KendaroDuong/imu-final-board/docs/Hardware Design - Rev-02 draft.docx

# Hardware Design

# Rev-01

### Description

Rev-01 is the first board revision meant as a working prototype. A defining characteristic of the first revision is the footprint being 60mm x60mm where as our stretch goal is to have the board in the m.2 2260 format.

### Goal

The goal of rev-01 is to simply break out the chosen sensors and connect their pinouts to the STM32-4f11 development board and support the early proof of concept testing.

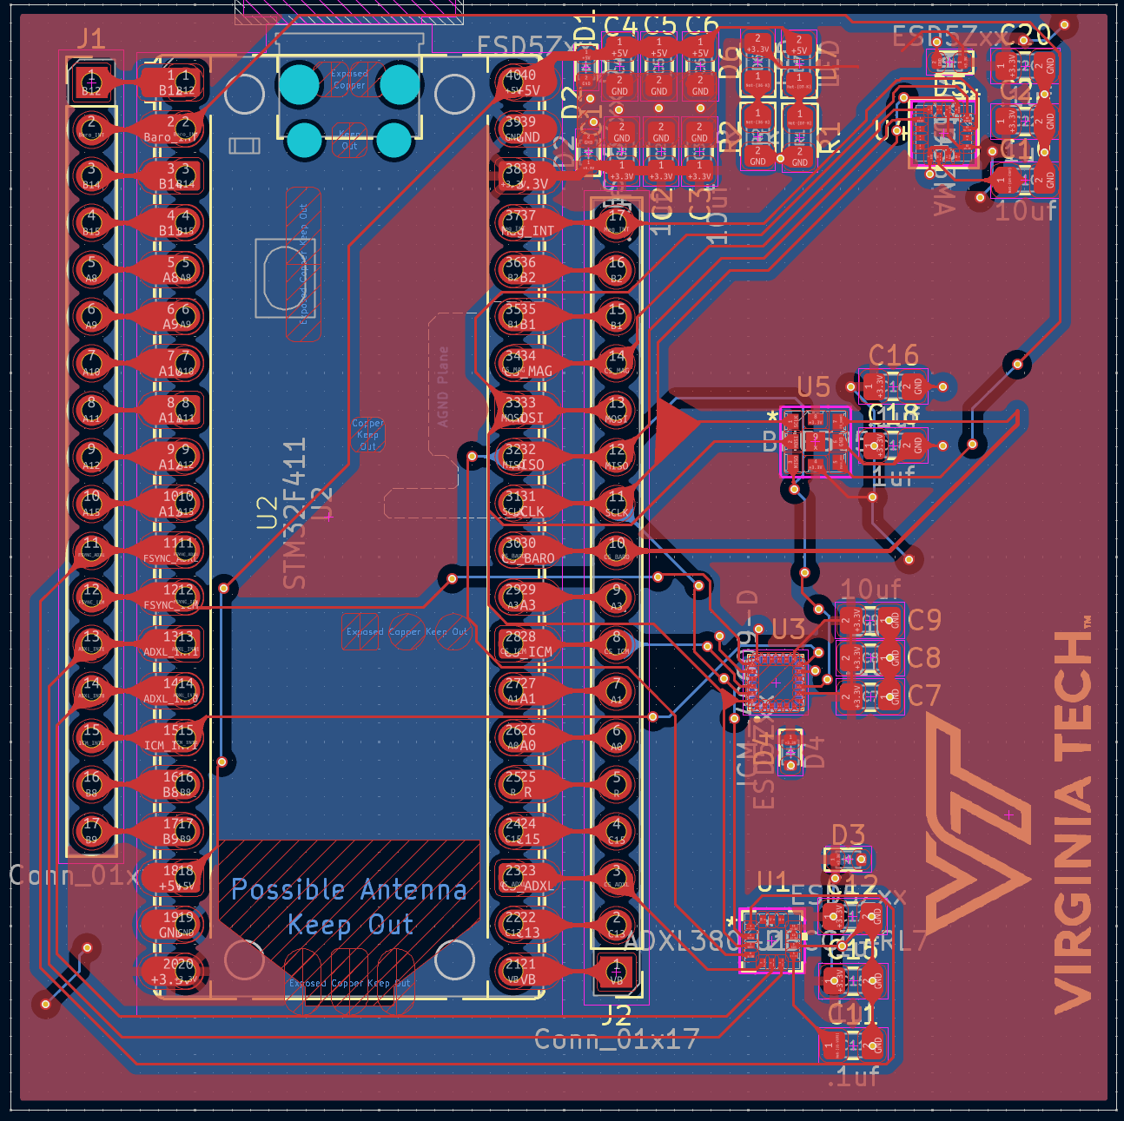
[picture p1: figure]
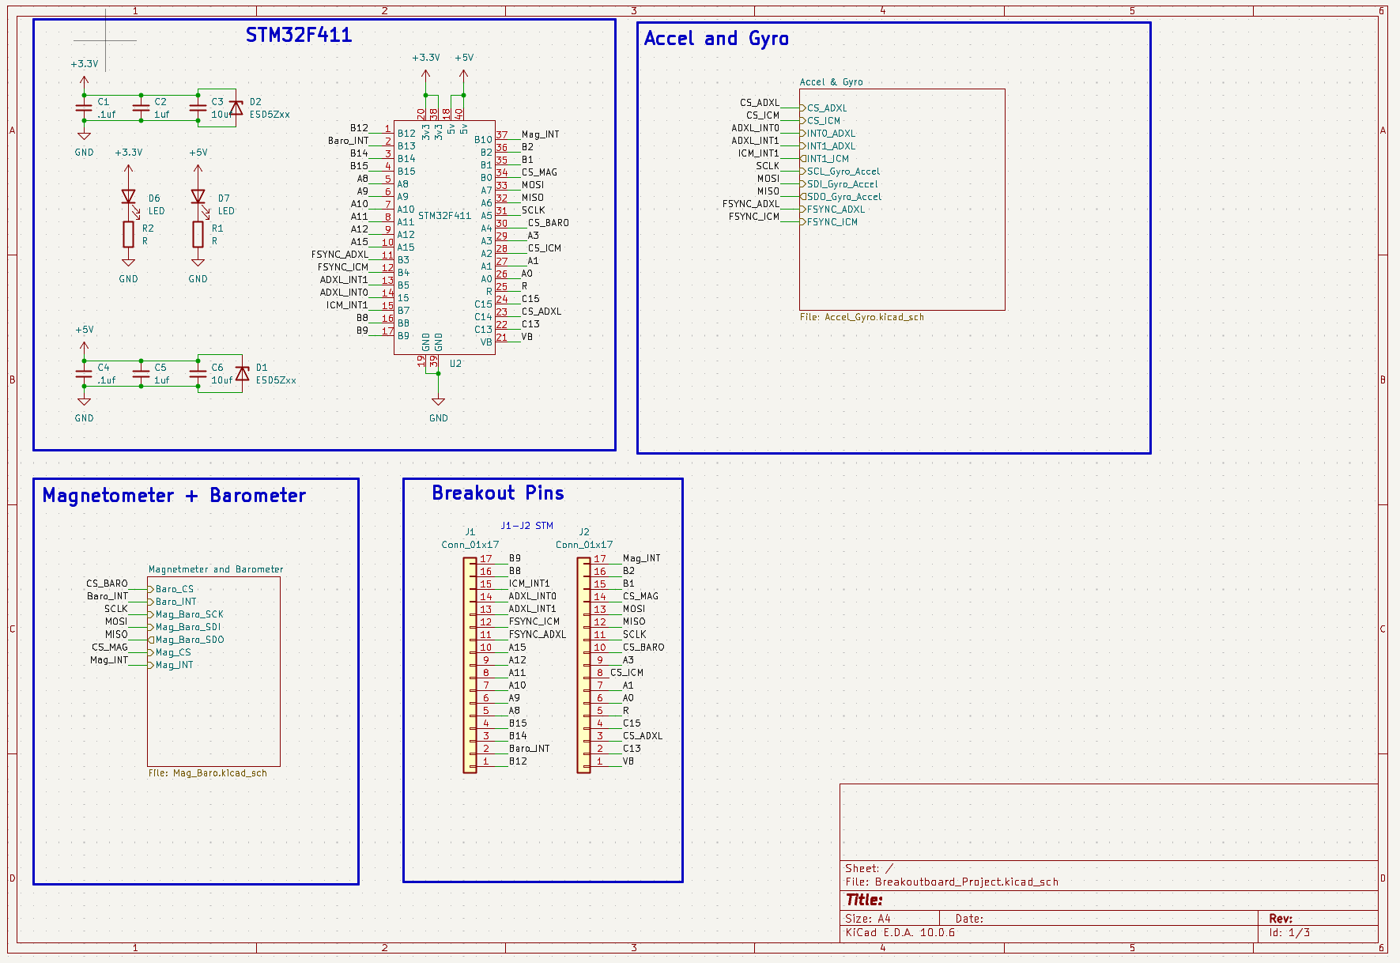
[picture p2: figure]

Requirements Supported

Need | How Rev-01 supports it | Test
N1 Linear acceleration | ADXL380, plus the second accelerometer in the ICM-40609-D | T1, T2
N2 Angular rate | ICM-40609-D gyroscope | T3, T4
N3 Absolute heading | MMC5983MA magnetometer | T5
N4 Altitude aiding | BMP585 barometer (300–1250 mbar, the marginal target) | T6
N5 Fast, deterministic data | Shared SPI1 bus, one chip select per sensor, interrupts and FSYNC lines routed to the MCU | T7, T8
N6 Integration (partial) | UART and USB-C through the Black Pill; 60 mm x 60 mm meets the marginal form factor of 100 mm x 100 mm or less | T9
N8 Real-time demo | Streams sensor data to the host PC for visualization | T13

# Rev-02

### Description

Rev-02 is the final board. It moves the design from a breakout board that carries a development board to a self-contained IMU card. The STM32F411 is soldered directly to the board, and the target footprint is the M.2 2260 format (22 mm x 60 mm). The sensors, shared SPI bus and sensor circuits stay the same as Rev-01, so the firmware and test results carry over. M.2 remains a stretch goal from Psionic. If it cannot be finished in time, the same circuit will be built on the Rev-01 60 mm x 60 mm outline.

### Goal

The goal of Rev-02 is to deliver a single board that Psionic can integrate with its navigation products. It should power itself from the host, stream measurements over UART and USB, and accept an external measurement trigger, with protection on every external connection.

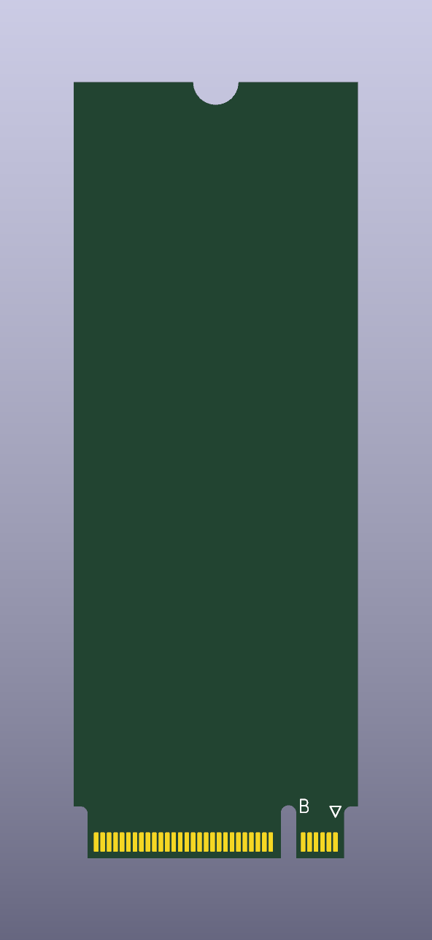
[picture p3: figure]
Rev-02 M.2 2260 Key B board outline rendered from KiCad

Figure: Rev-02 M.2 2260 Key B outline in KiCad. Placement and routing have not started.

### Changes from Rev-01

Area | Rev-01 breakout board | Rev-02 final board | Why
Form factor | 60 mm x 60 mm, 2-layer, 1.6 mm thick | M.2 2260 (22 mm x 60 mm), Key B, 4-layer, 0.8 mm thick | Psionic's M.2 integration goal. The narrow board needs inner ground and power layers.
Microcontroller | Black Pill development board plugged into headers | STM32F411CEU6 soldered directly to the board, with crystal, VCAP capacitor, BOOT0 pull-down and reset circuit | The Black Pill does not fit on an M.2 card. Using the same MCU keeps the firmware portable.
Power | USB 5 V to the Black Pill's 3.3 V regulator; +5 V and +3.3 V rails | 3.3 V from the M.2 connector, filtered for the sensors; no +5 V rail or USB-C connector | M.2 hosts supply 3.3 V directly.
Host link | UART and USB through the Black Pill | USB 2.0 and UART through M.2 connector pins | Keeps the UART baseline and the USB stretch goal without a separate connector.
External trigger | None; FSYNC is driven only by MCU pins | New protected TRIG_IN with series resistor and clamp, on a timer capture pin (PA0, TIM5_CH1) | The V&V plan uses an external trigger of about 50 µs every 10 ms, which must stay within the 3.3 V GPIO limits.
ESD protection | TVS diodes on the power rails only | Protection on every external line: USB, UART, TRIG_IN and power | Required by V&V tests TC04 and TC06.
ADXL380 chip select | PC14 | PA3 | PC13–PC15 are limited to 2 MHz, 30 pF and a 3 mA sink (STM32F411 datasheet).
Test access | J1 and J2, 2.54 mm headers | Test pads for SPI, CS, INT, FSYNC, TRIG_IN, UART, SWD and power | Through-hole headers do not fit on the card.
Bench connection | Black Pill USB-C connects directly to the PC | Small M.2 carrier board with socket, USB-C, UART and trigger connectors, and 2.54 mm headers | The card cannot connect to a laptop by itself, and the V&V plan expects 2.54 mm probe access.
Passives and LEDs | 0805 hand-solder parts; power LEDs on both rails | Smaller passives where needed; one 3.3 V power LED and one MCU status LED | Saves board area, and the +5 V rail is gone.
Sensor placement | Sensors spread around the Black Pill | Accelerometer and gyroscope close together away from board edges; magnetometer away from the steel mounting screw and high-current traces | Reduces board-flex and magnetic error on the longer, thinner card.

### What Stays the Same

Rev-02 keeps the ADXL380, ICM-40609-D, MMC5983MA and BMP585, the shared SPI1 bus (PA5, PA6, PA7), one chip select per sensor, the interrupt and FSYNC pin assignments, and the decoupling on each sensor. The only sensor pin that moves is the ADXL380 chip select.

## Requirements Supported

Need | How Rev-02 supports it | Test
N1–N4 Sensing | Same four sensors and sensor circuits as Rev-01 | T1–T6
N5 Fast, deterministic data | Direct MCU connection to the sensors; timer capture of the external trigger | T7, T8
N6 Integration with Psionic | UART and USB over M.2, protected external sync input, M.2 2260 form factor (ideal target) | T9, T10
N7 Field environment | 3.3 V supply within the 3.2–5.2 V target; no 5 V regulator losses, with power still to be measured against the 280 mW target | T11, T12
N8 Real-time demo | Connects to the host PC through the carrier board | T13

### Open Decisions

Open decision | Owner | Proposed answer
Which M.2 key does Psionic's host use? | Team / Psionic | Key B, because it includes USB 2.0 and fits the 2260 size
Which M.2 pins carry UART and TRIG_IN? | Team / Psionic | To be chosen after checking the M.2 specification, since these signals are not standard M.2 functions
Is the carrier board in scope? | Team / mentor | Yes, as a simple 2-layer board for the demo and V&V
Can the team assemble 0.8 mm, fine-pitch boards? | Team / lab staff | Use a stencil, or fab assembly if hand assembly is not reliable
What is the fallback if M.2 slips? | Team / mentor | Same circuit on the 60 mm x 60 mm outline, with USB-C and a 3.3 V regulator
