KendaroDuong/imu-final-board/docs/Final_Board_schematic.pdf

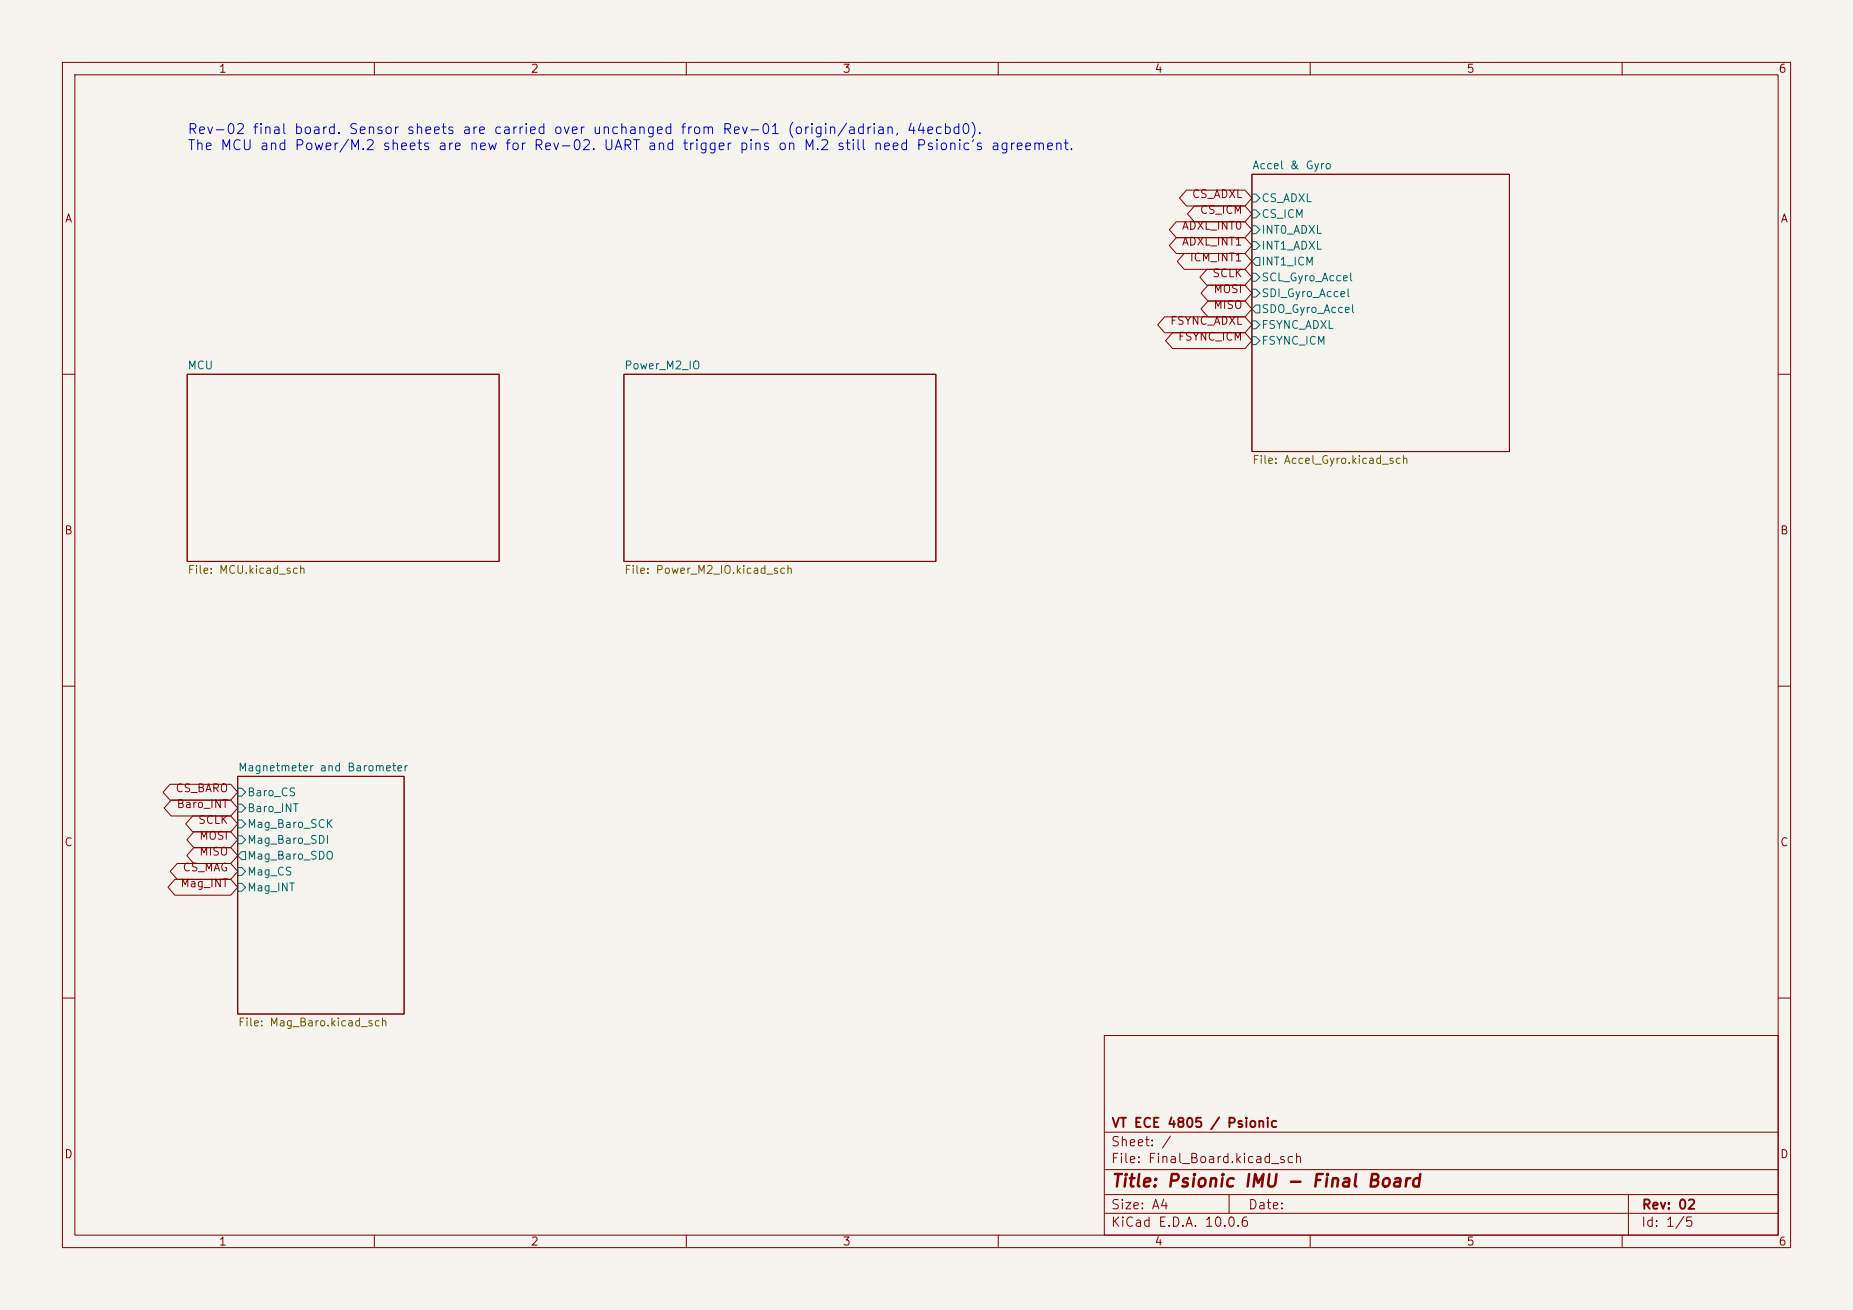
[picture p4: page 1]

Rev-02 final board. Sensor sheets are carried over unchanged from Rev-01 (origin/adrian, 44ecbd0).
The MCU and Power/M.2 sheets are new for Rev-02. UART and trigger pins on M.2 still need Psionic's agreement.

Magnetmeter and Barometer File: Mag_Baro.kicad_sch

VT ECE 4805 / Psionic
Sheet: /
File: Final_Board.kicad_sch
Title: Psionic IMU - Final Board

Size: A4 | Rev: 02
KiCad E.D.A. 10.0.6 | Id: 1/5

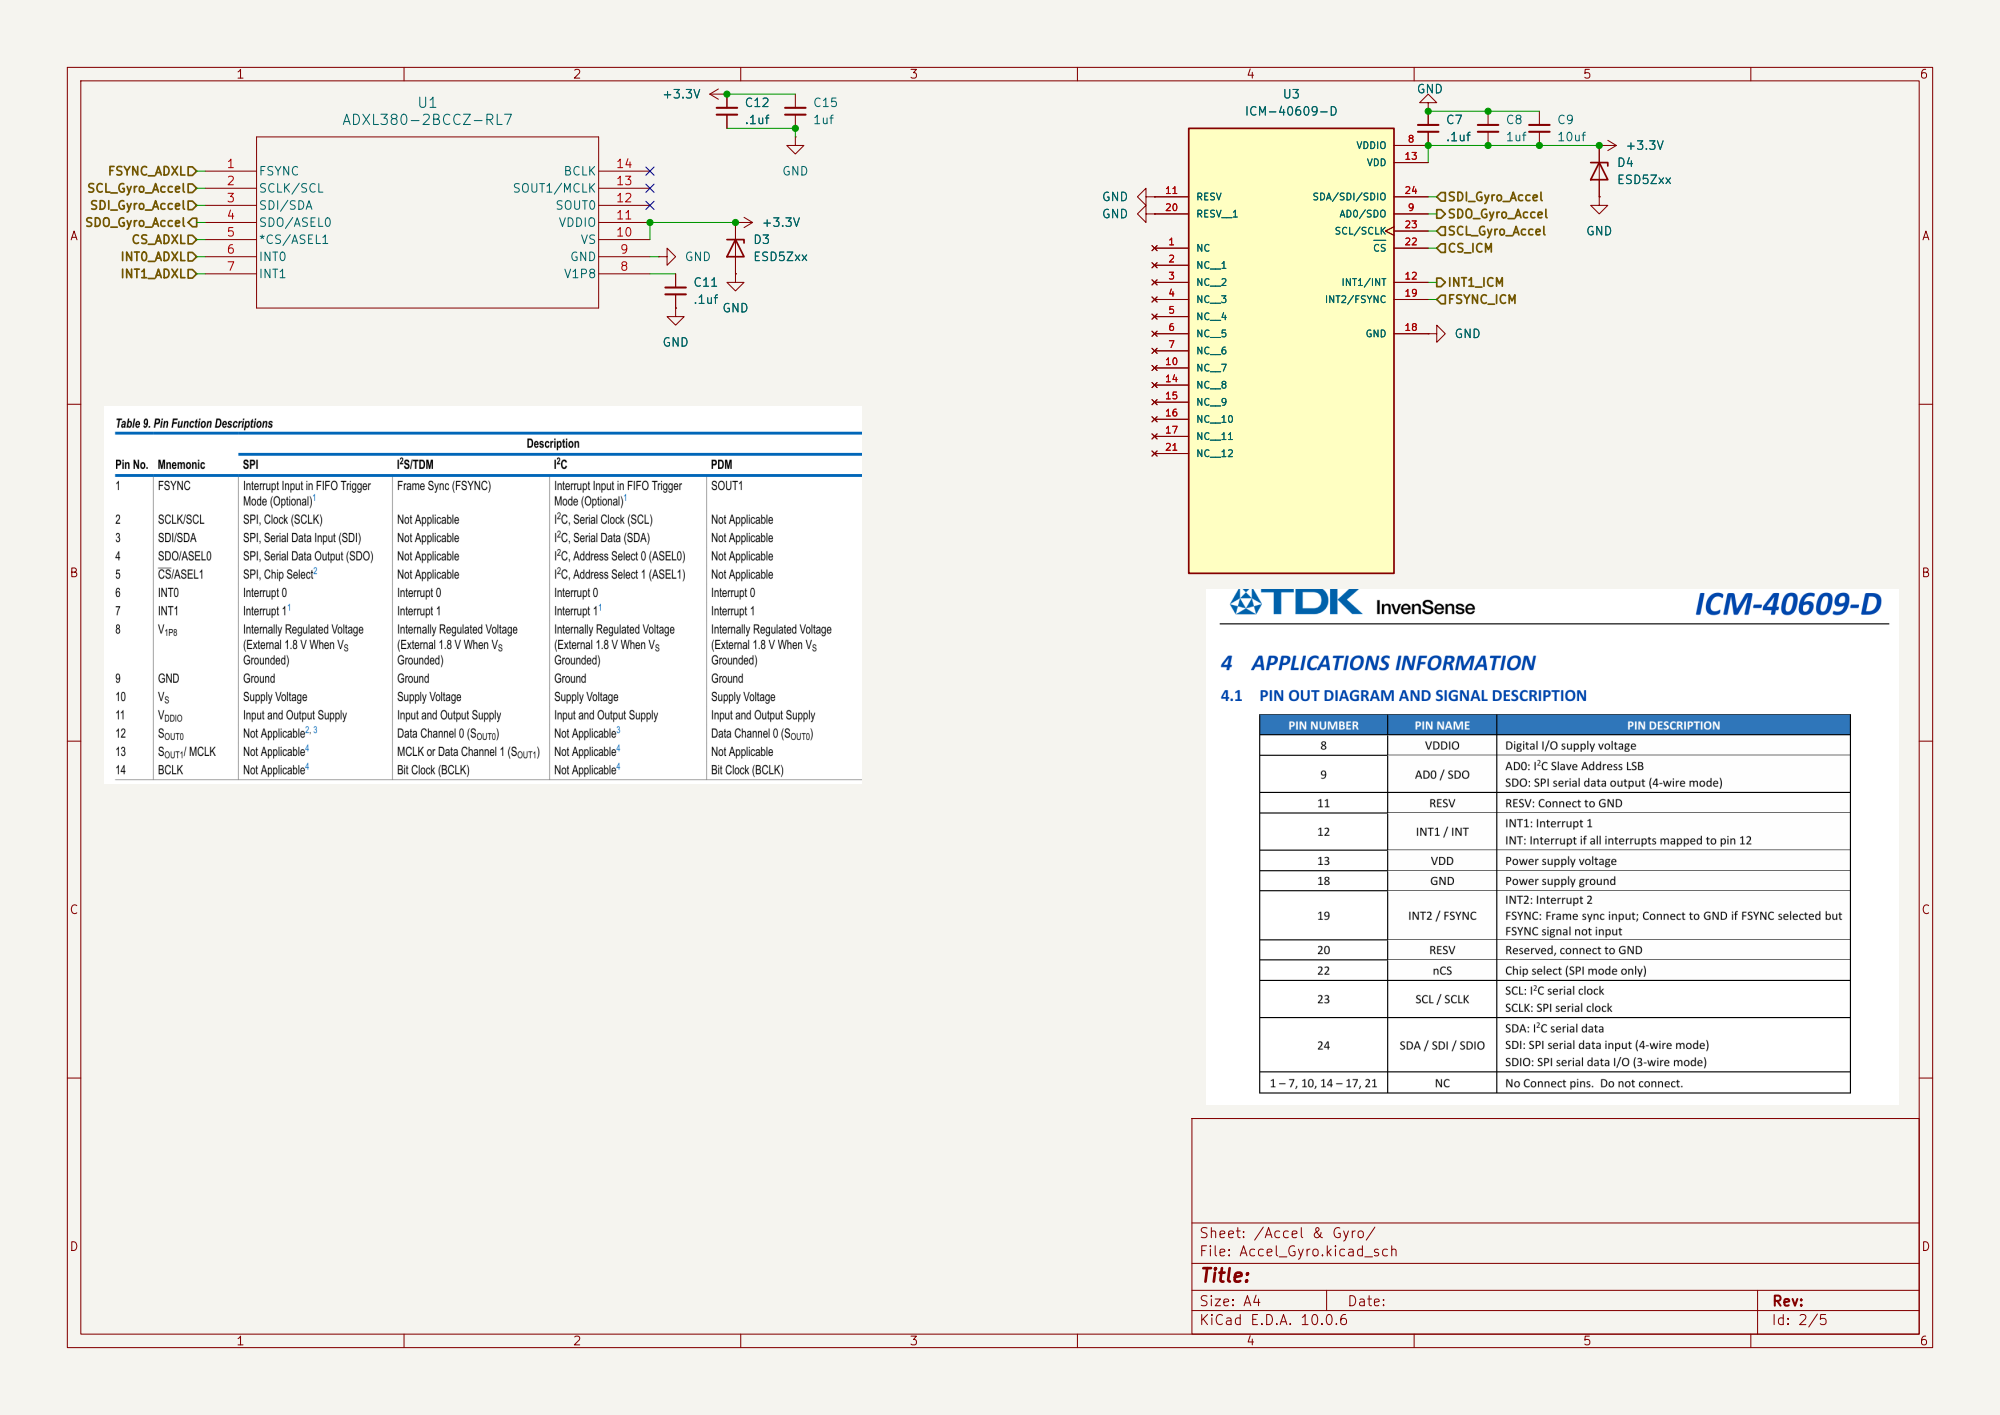
[picture p5: page 2]

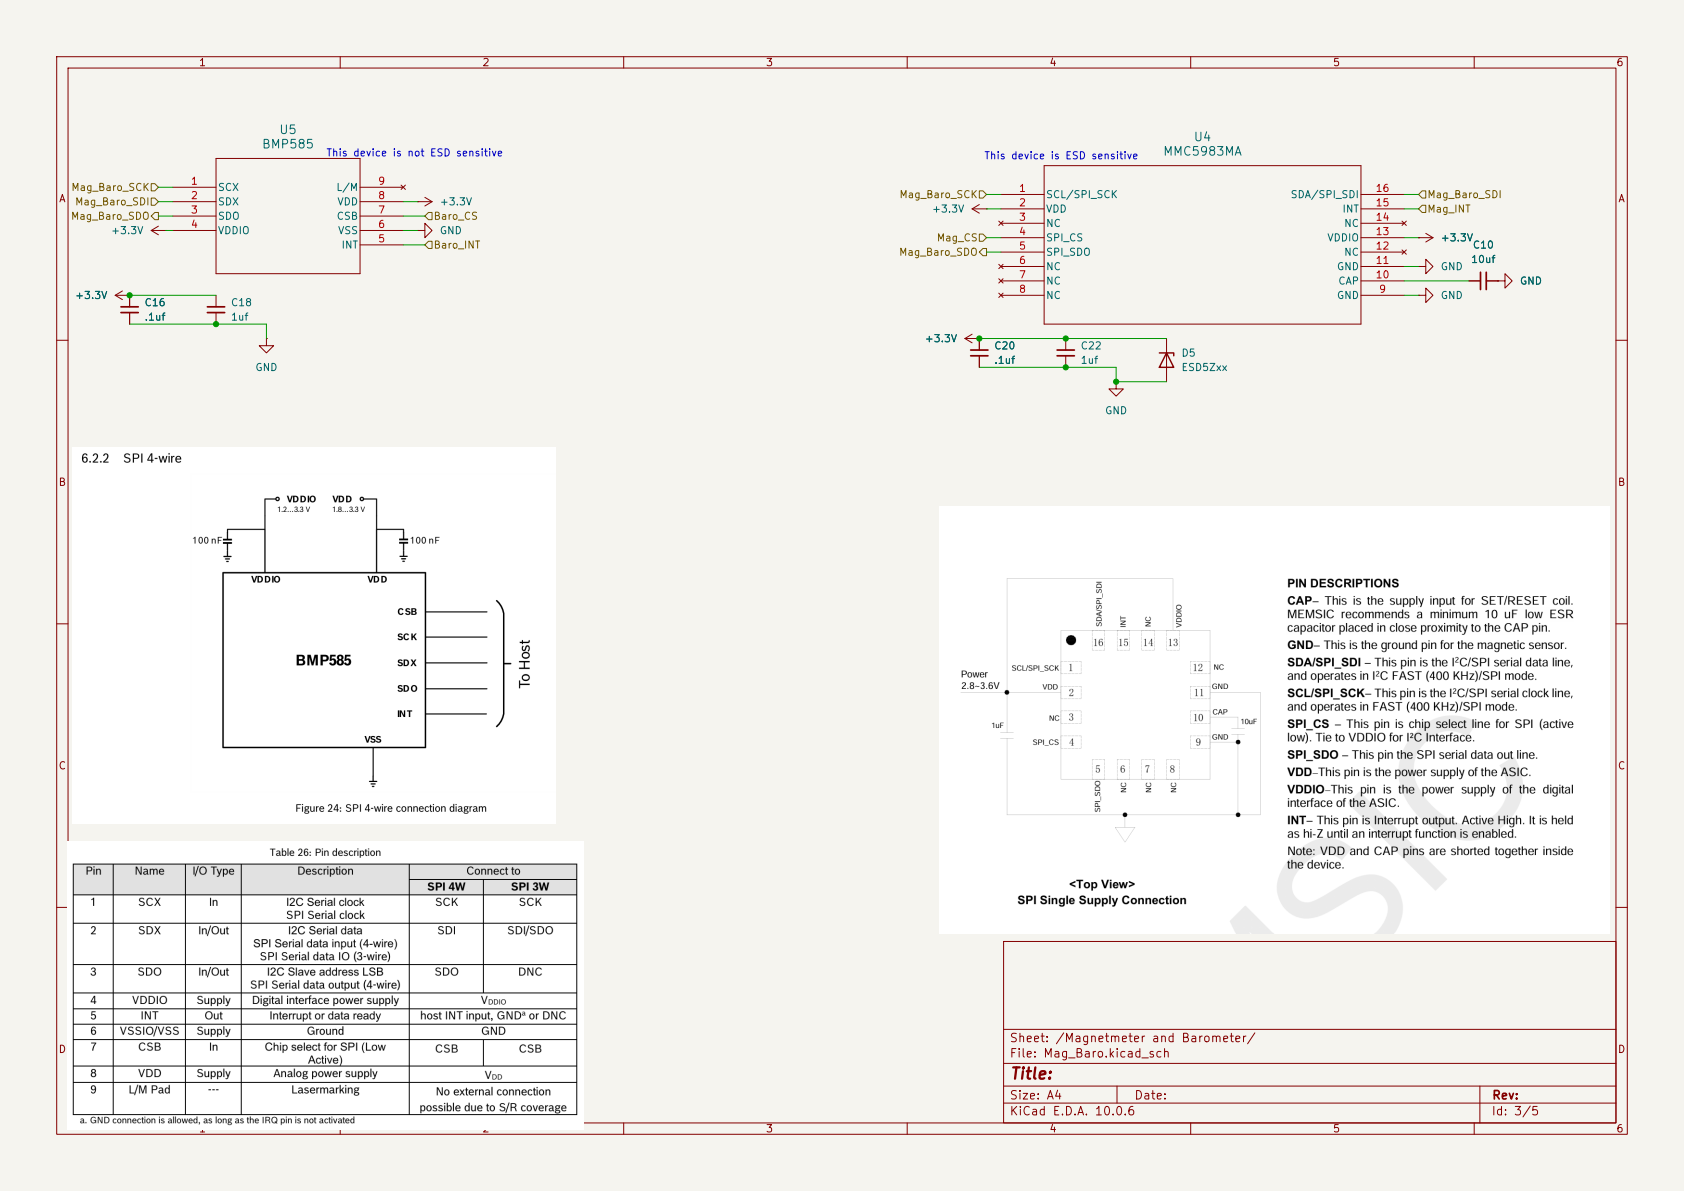
[picture p6: page 3]

Sheet: /Magnetmeter and Barometer/
File: Mag_Baro.kicad_sch
Title:

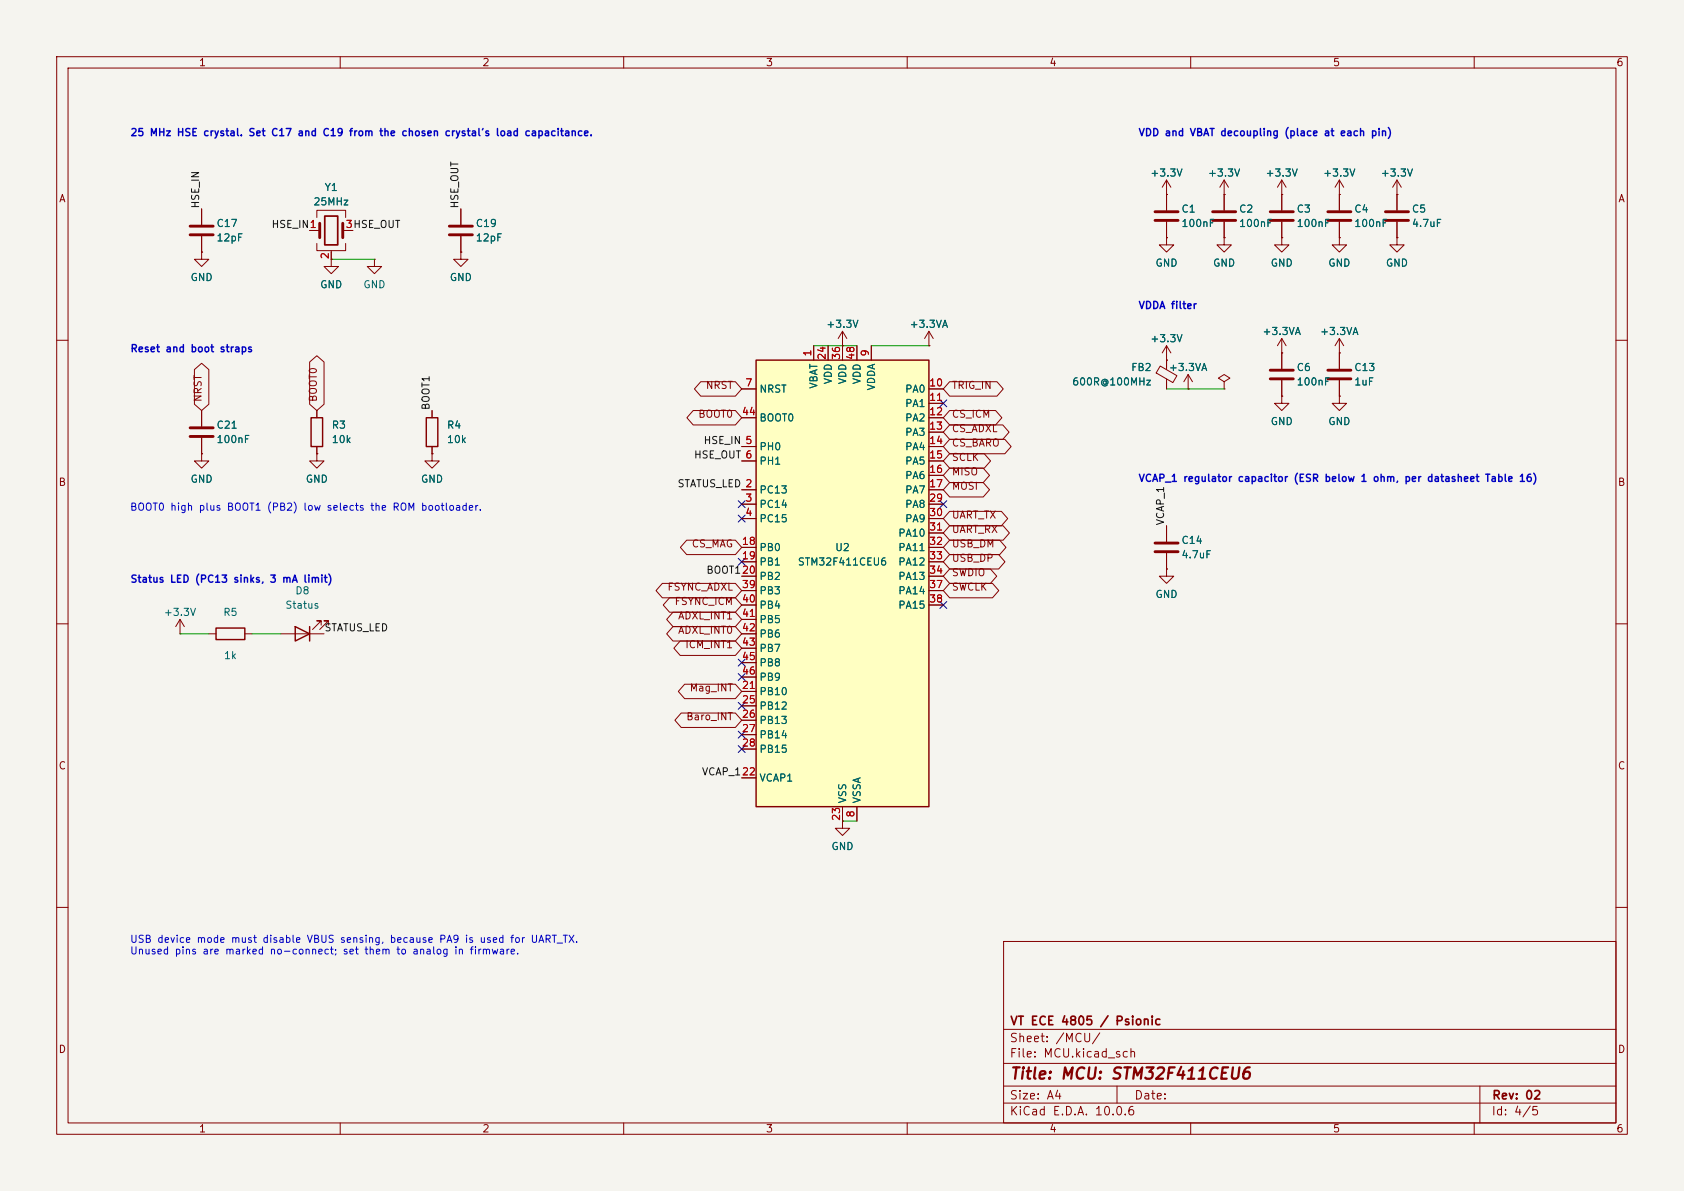
[picture p7: page 4]

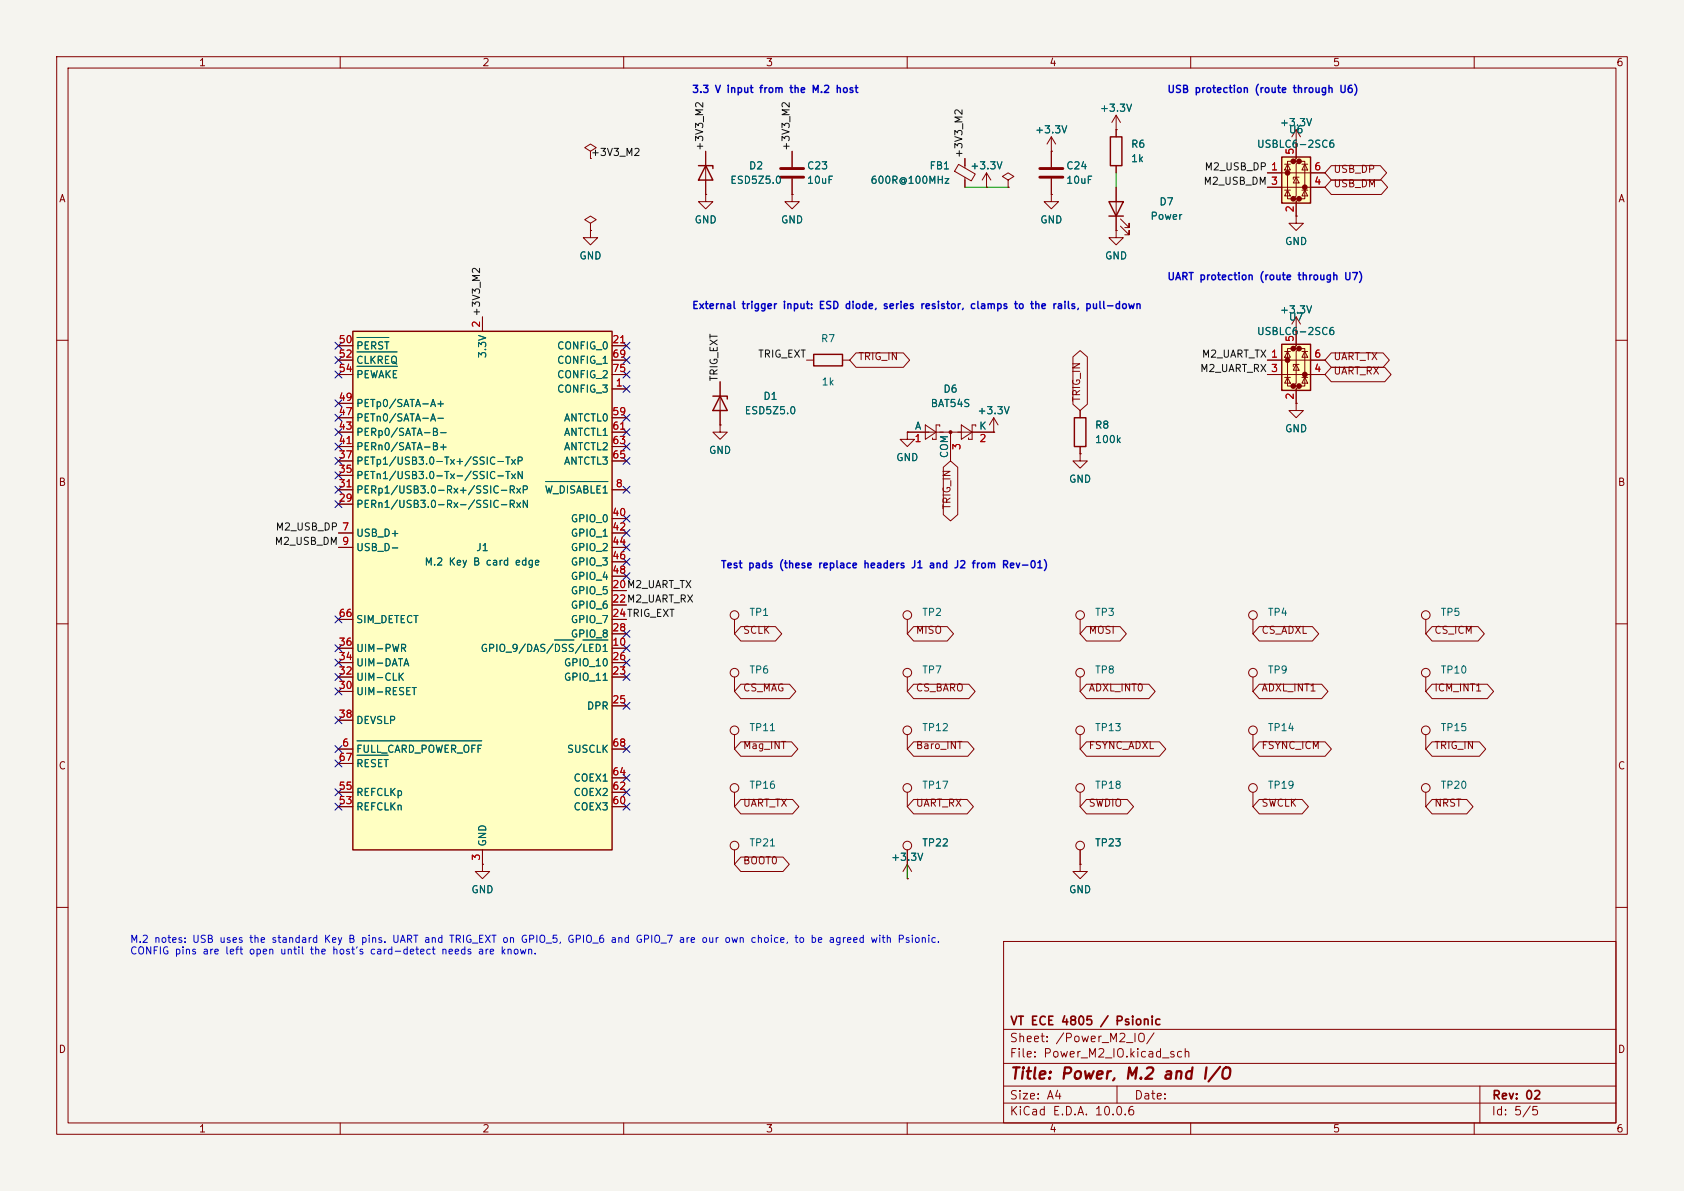
[picture p8: page 5]
