KendaroDuong/imu-final-board/Final_Board/Accel_Gyro.kicad_sch

## KiCad design Final_Board/Accel_Gyro.kicad_sch (2026-11-06)

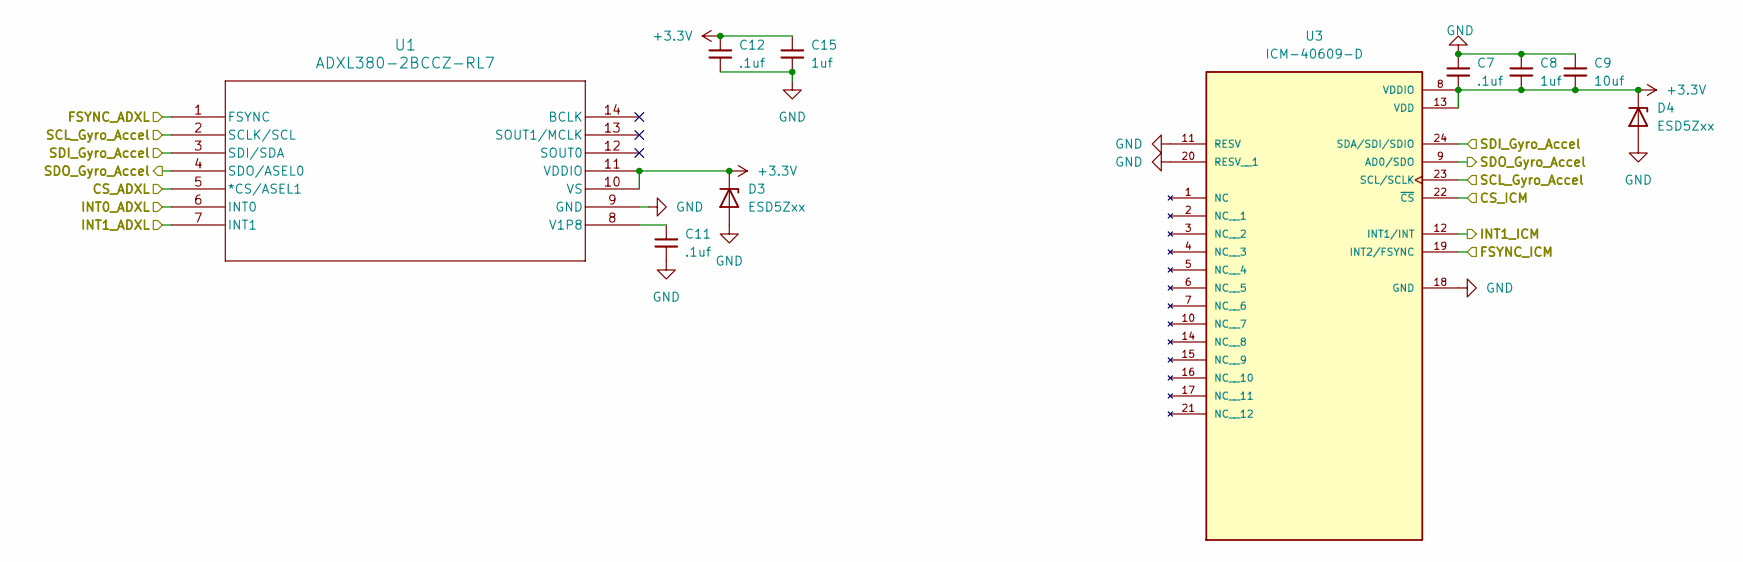
[picture p9: schematic Accel_Gyro.kicad_sch]

Parts:
C7, C11, C12: .1uf; C_0805_2012Metric_Pad1.18x1.45mm_HandSolder
C8, C15: 1uf; C_0805_2012Metric_Pad1.18x1.45mm_HandSolder
C9: 10uf; C_0805_2012Metric_Pad1.18x1.45mm_HandSolder
D3, D4: ESD5Zxx; D_SOD-523
U1: ADXL380-2BCCZ-RL7; CC-14-3_ADI
U3: ICM-40609-D; XDCR_ICM-40609-D; PARTREV 1.2

Connections:
+3.3V: C7.2, C8.2, C9.2, C12.1, C15.1, D3.1 (K), D4.1 (K), U1.10 (VS), U1.11 (VDDIO), U3.8 (VDDIO), U3.13 (VDD)
CS_ADXL: U1.5 (*CS/ASEL1)
CS_ICM: U3.22 (~CS)
FSYNC_ADXL: U1.1 (FSYNC)
FSYNC_ICM: U3.19 (INT2/FSYNC)
GND: C7.1, C8.1, C9.1, C11.2, C12.2, C15.2, D3.2 (A), D4.2 (A), U1.9 (GND), U3.11 (RESV), U3.18 (GND), U3.20 (RESV__1)
INT0_ADXL: U1.6 (INT0)
INT1_ADXL: U1.7 (INT1)
INT1_ICM: U3.12 (INT1/INT)
unnamed: C11.1, U1.8 (V1P8)
SCL_Gyro_Accel: U1.2 (SCLK/SCL), U3.23 (SCL/SCLK)
SDI_Gyro_Accel: U1.3 (SDI/SDA), U3.24 (SDA/SDI/SDIO)
SDO_Gyro_Accel: U1.4 (SDO/ASEL0), U3.9 (AD0/SDO)
