KendaroDuong/imu-final-board/Final_Board/MCU.kicad_sch

## KiCad design Final_Board/MCU.kicad_sch (2026-11-06)

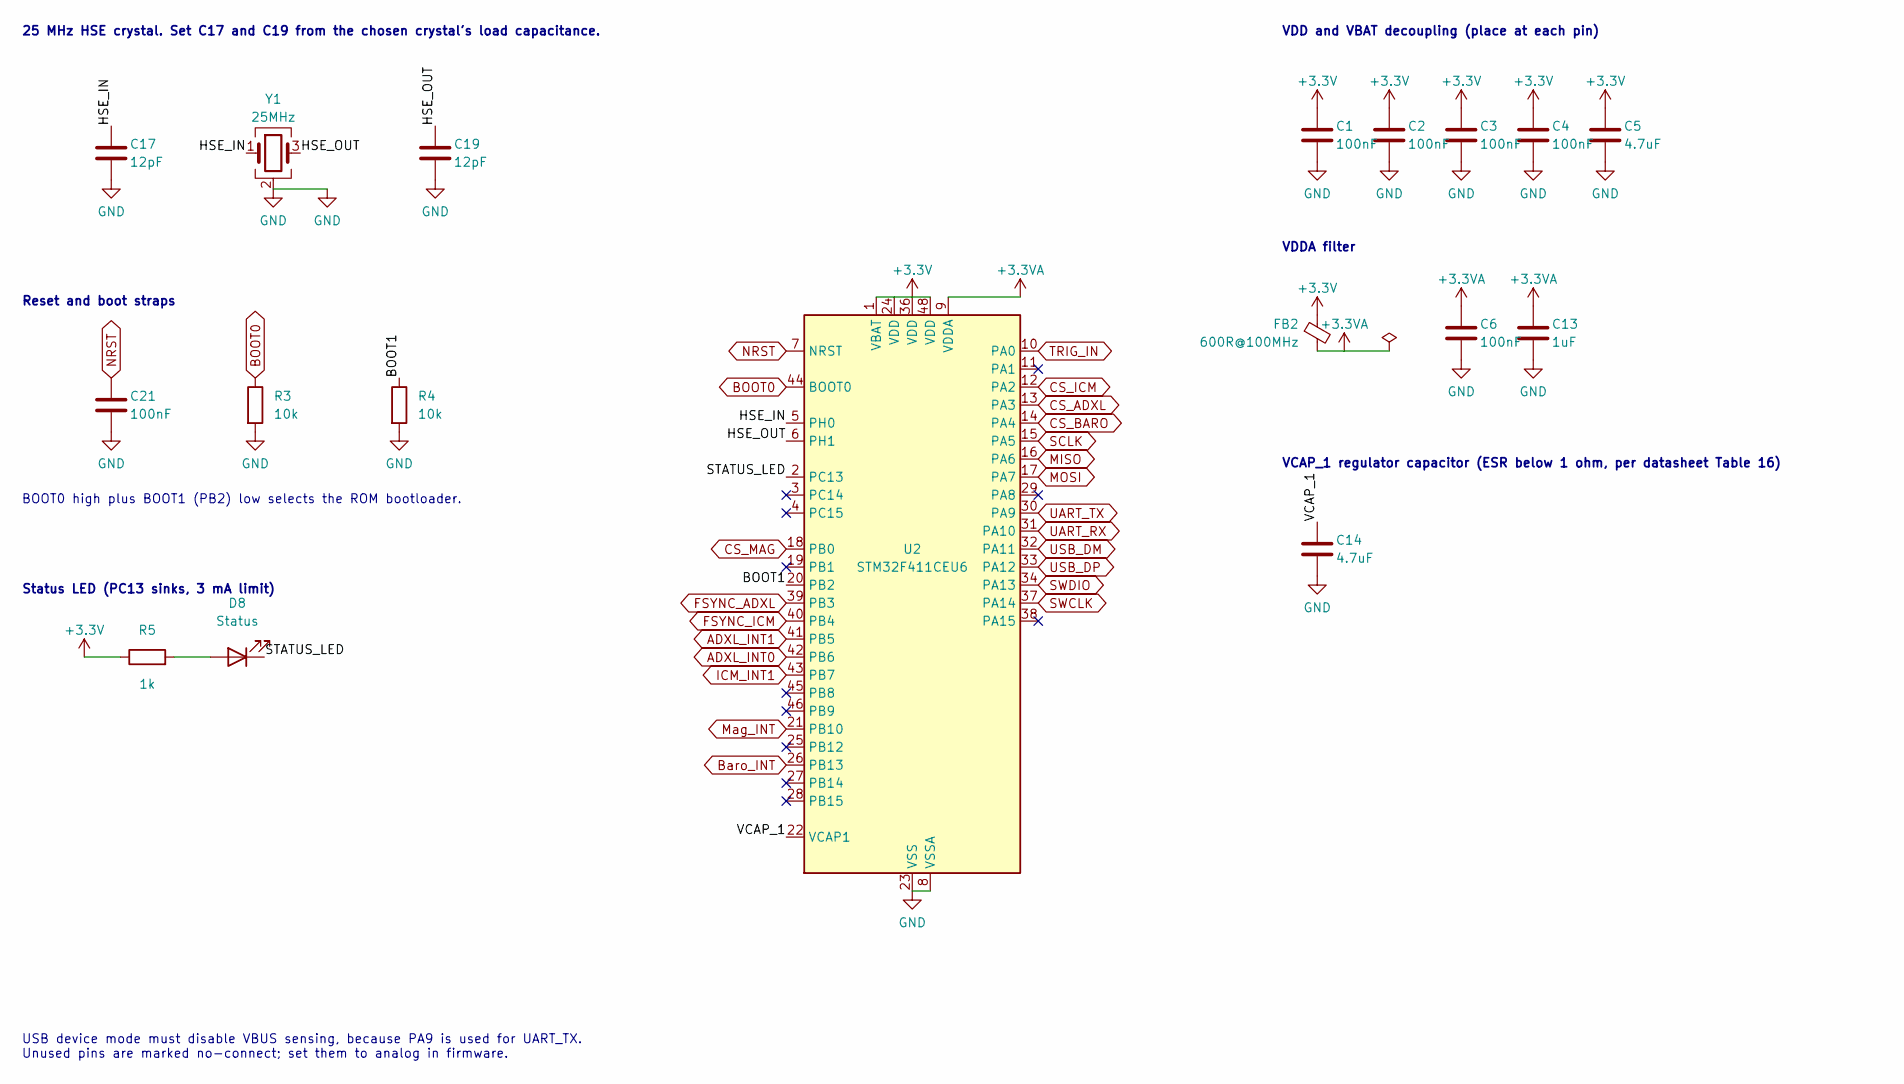
[picture p10: schematic MCU.kicad_sch]

Parts:
C1, C2, C3, C4, C6, C21: 100nF; C_0402_1005Metric
C5, C14: 4.7uF; C_0603_1608Metric
C13: 1uF; C_0402_1005Metric
C17, C19: 12pF; C_0402_1005Metric
D8: Status; LED_0603_1608Metric
FB2: 600R@100MHz; L_0402_1005Metric
R3, R4: 10k; R_0402_1005Metric
R5: 1k; R_0402_1005Metric
U2: STM32F411CEU6; QFN-48-1EP_7x7mm_P0.5mm_EP5.6x5.6mm
Y1: 25MHz; Crystal_SMD_3225-4Pin_3.2x2.5mm

Connections:
+3.3V: C1.1, C2.1, C3.1, C4.1, C5.1, FB2.1, R5.1, U2.1 (VBAT), U2.24 (VDD), U2.36 (VDD), U2.48 (VDD)
+3.3VA: C6.1, C13.1, FB2.2, U2.9 (VDDA)
ADXL_INT0: U2.42 (PB6)
ADXL_INT1: U2.41 (PB5)
BOOT0: R3.1, U2.44 (BOOT0)
BOOT1: R4.1, U2.20 (PB2)
Baro_INT: U2.26 (PB13)
CS_ADXL: U2.13 (PA3)
CS_BARO: U2.14 (PA4)
CS_ICM: U2.12 (PA2)
CS_MAG: U2.18 (PB0)
FSYNC_ADXL: U2.39 (PB3)
FSYNC_ICM: U2.40 (PB4)
GND: C1.2, C2.2, C3.2, C4.2, C5.2, C6.2, C13.2, C14.2, C17.2, C19.2, C21.2, R3.2, R4.2, U2.8 (VSSA), U2.23 (VSS), U2.35 (VSS), U2.47 (VSS), U2.49 (VSS), Y1.2 (G), Y1.4 (G)
HSE_IN: C17.1, U2.5 (PH0), Y1.1
HSE_OUT: C19.1, U2.6 (PH1), Y1.3
ICM_INT1: U2.43 (PB7)
MISO: U2.16 (PA6)
MOSI: U2.17 (PA7)
Mag_INT: U2.21 (PB10)
NRST: C21.1, U2.7 (NRST)
unnamed: D8.2 (A), R5.2
SCLK: U2.15 (PA5)
STATUS_LED: D8.1 (K), U2.2 (PC13)
SWCLK: U2.37 (PA14)
SWDIO: U2.34 (PA13)
TRIG_IN: U2.10 (PA0)
UART_RX: U2.31 (PA10)
UART_TX: U2.30 (PA9)
USB_DM: U2.32 (PA11)
USB_DP: U2.33 (PA12)
VCAP_1: C14.1, U2.22 (VCAP1)

Notes on the sheet:
VDD and VBAT decoupling (place at each pin)
Status LED (PC13 sinks, 3 mA limit)
BOOT0 high plus BOOT1 (PB2) low selects the ROM bootloader.
VDDA filter
Reset and boot straps
VCAP_1 regulator capacitor (ESR below 1 ohm, per datasheet Table 16)
25 MHz HSE crystal. Set C17 and C19 from the chosen crystal's load capacitance.
USB device mode must disable VBUS sensing, because PA9 is used for UART_TX. Unused pins are marked no-connect; set them to analog in firmware.
