KendaroDuong/imu-final-board/Final_Board/Mag_Baro.kicad_sch

## KiCad design Final_Board/Mag_Baro.kicad_sch (2026-11-06)

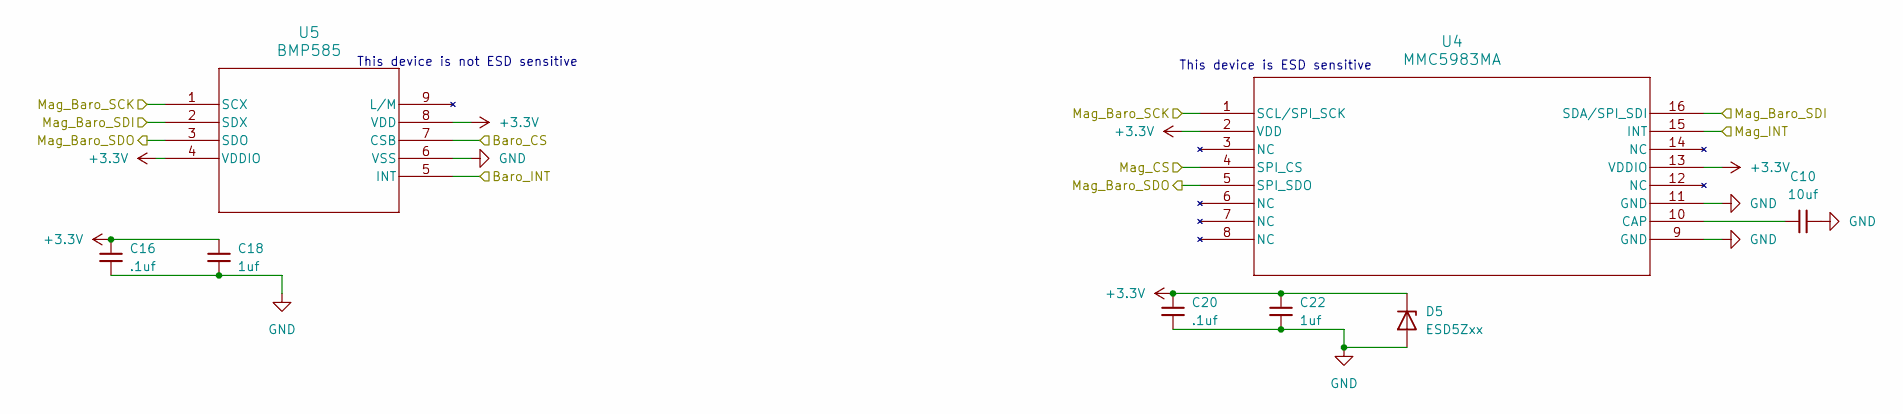
[picture p11: schematic Mag_Baro.kicad_sch]

Parts:
C10: 10uf; C_0805_2012Metric_Pad1.18x1.45mm_HandSolder
C16, C20: .1uf; C_0805_2012Metric_Pad1.18x1.45mm_HandSolder
C18, C22: 1uf; C_0805_2012Metric_Pad1.18x1.45mm_HandSolder
D5: ESD5Zxx; D_SOD-523
U4: MMC5983MA; MMC5983MA_MEM
U5: BMP585; LGA9_BMP585_BOS

Connections:
+3.3V: C16.1, C18.1, C20.1, C22.1, D5.1 (K), U4.2 (VDD), U4.13 (VDDIO), U5.4 (VDDIO), U5.8 (VDD)
Baro_CS: U5.7 (CSB)
Baro_INT: U5.5 (INT)
GND: C10.2, C16.2, C18.2, C20.2, C22.2, D5.2 (A), U4.9 (GND), U4.11 (GND), U5.6 (VSS)
Mag_Baro_SCK: U4.1 (SCL/SPI_SCK), U5.1 (SCX)
Mag_Baro_SDI: U4.16 (SDA/SPI_SDI), U5.2 (SDX)
Mag_Baro_SDO: U4.5 (SPI_SDO), U5.3 (SDO)
Mag_CS: U4.4 (SPI_CS)
Mag_INT: U4.15 (INT)
unnamed: C10.1, U4.10 (CAP)

Notes on the sheet:
This device is not ESD sensitive
This device is ESD sensitive
