KendaroDuong/imu-final-board/Final_Board/Power_M2_IO.kicad_sch

## KiCad design Final_Board/Power_M2_IO.kicad_sch (2026-11-06)

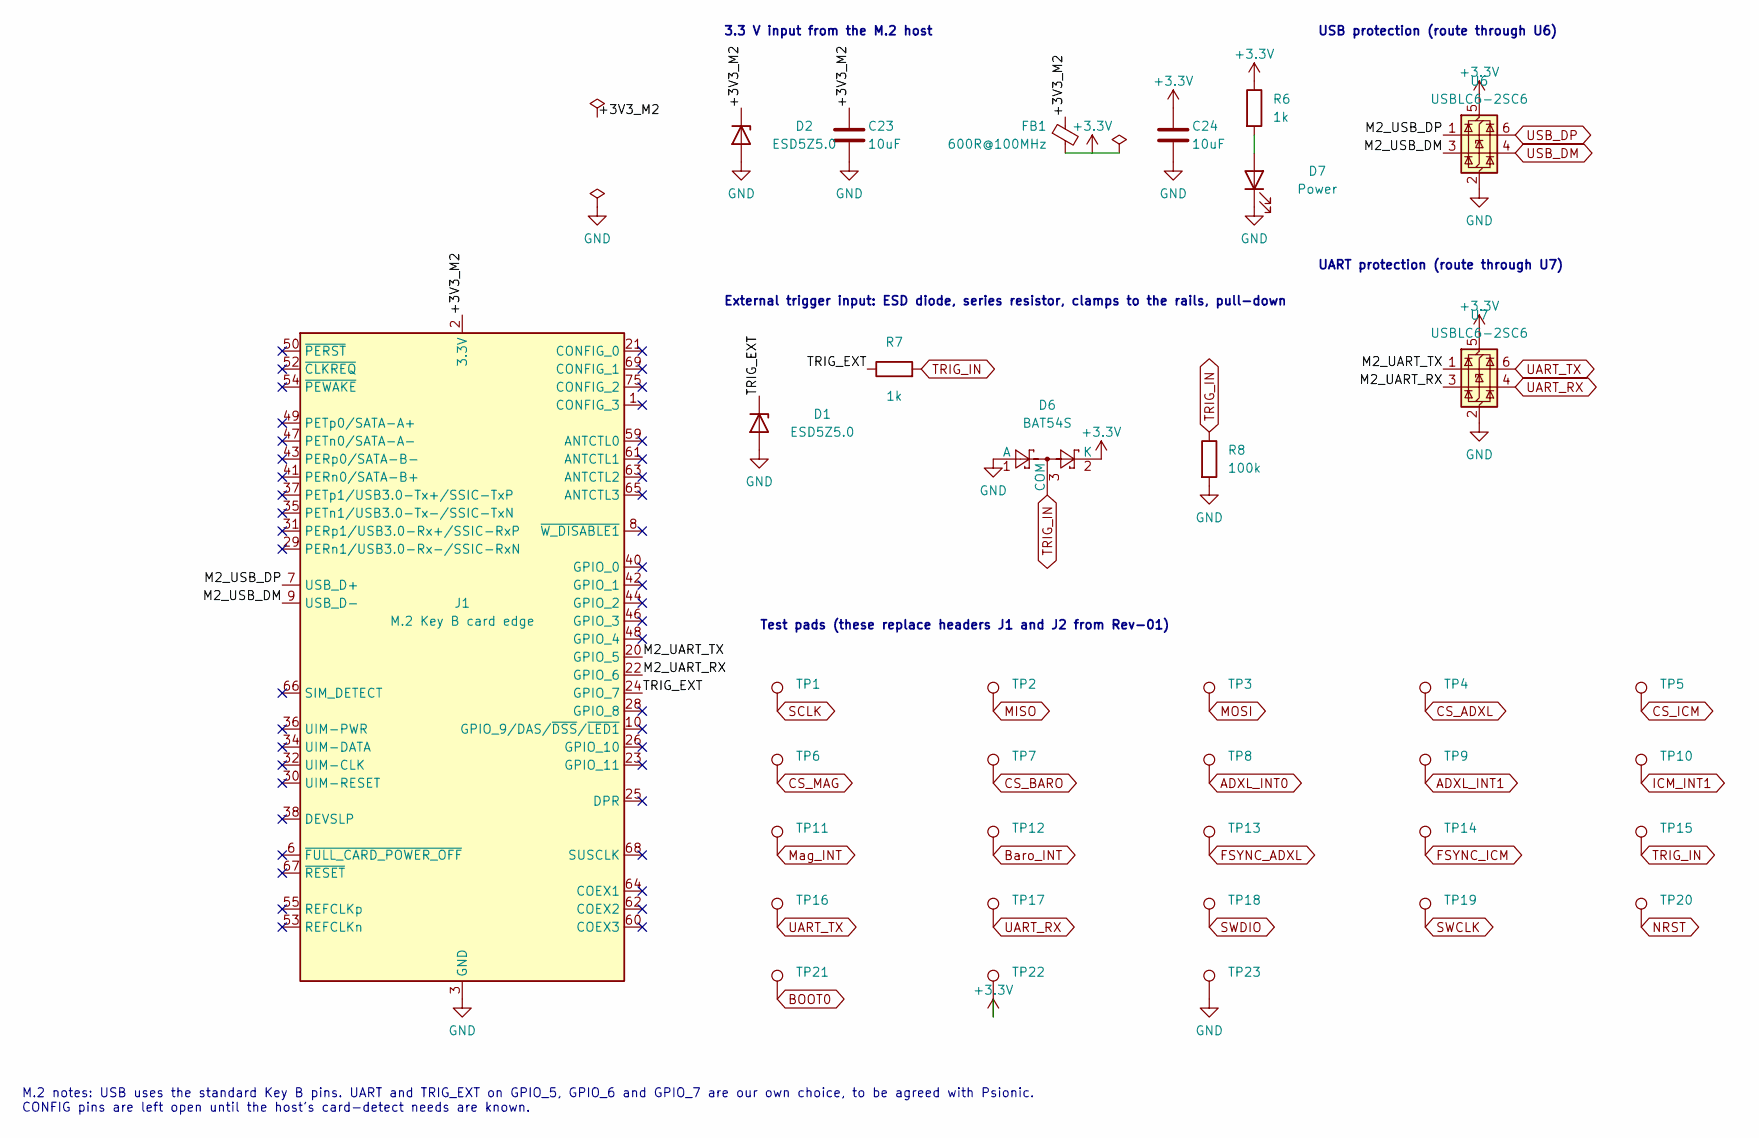
[picture p12: schematic Power_M2_IO.kicad_sch]

Parts:
C23, C24: 10uF; C_0603_1608Metric
D1, D2: ESD5Z5.0; D_SOD-523
D6: BAT54S; SOT-23
D7: Power; LED_0603_1608Metric
FB1: 600R@100MHz; L_0402_1005Metric
J1: M.2 Key B card edge; M.2_2260-xx-B
R6, R7: 1k; R_0402_1005Metric
R8: 100k; R_0402_1005Metric
TP1: SCLK; TestPoint_Pad_D1.0mm
TP2: MISO; TestPoint_Pad_D1.0mm
TP3: MOSI; TestPoint_Pad_D1.0mm
TP4: CS_ADXL; TestPoint_Pad_D1.0mm
TP5: CS_ICM; TestPoint_Pad_D1.0mm
TP6: CS_MAG; TestPoint_Pad_D1.0mm
TP7: CS_BARO; TestPoint_Pad_D1.0mm
TP8: ADXL_INT0; TestPoint_Pad_D1.0mm
TP9: ADXL_INT1; TestPoint_Pad_D1.0mm
TP10: ICM_INT1; TestPoint_Pad_D1.0mm
TP11: Mag_INT; TestPoint_Pad_D1.0mm
TP12: Baro_INT; TestPoint_Pad_D1.0mm
TP13: FSYNC_ADXL; TestPoint_Pad_D1.0mm
TP14: FSYNC_ICM; TestPoint_Pad_D1.0mm
TP15: TRIG_IN; TestPoint_Pad_D1.0mm
TP16: UART_TX; TestPoint_Pad_D1.0mm
TP17: UART_RX; TestPoint_Pad_D1.0mm
TP18: SWDIO; TestPoint_Pad_D1.0mm
TP19: SWCLK; TestPoint_Pad_D1.0mm
TP20: NRST; TestPoint_Pad_D1.0mm
TP21: BOOT0; TestPoint_Pad_D1.0mm
TP22: +3.3V; TestPoint_Pad_D1.0mm
TP23: GND; TestPoint_Pad_D1.0mm
U6, U7: USBLC6-2SC6; SOT-23-6

Connections:
+3.3V: C24.1, D6.2 (K), FB1.2, R6.1, TP22.1, U6.5 (VBUS), U7.5 (VBUS)
+3V3_M2: C23.1, D2.1 (K), FB1.1, J1.2 (3.3V), J1.4 (3.3V), J1.70 (3.3V), J1.72 (3.3V), J1.74 (3.3V)
ADXL_INT0: TP8.1
ADXL_INT1: TP9.1
BOOT0: TP21.1
Baro_INT: TP12.1
CS_ADXL: TP4.1
CS_BARO: TP7.1
CS_ICM: TP5.1
CS_MAG: TP6.1
FSYNC_ADXL: TP13.1
FSYNC_ICM: TP14.1
GND: C23.2, C24.2, D1.2 (A), D2.2 (A), D6.1 (A), D7.1 (K), J1.3 (GND), J1.5 (GND), J1.11 (GND), J1.27 (GND), J1.33 (GND), J1.39 (GND), J1.45 (GND), J1.51 (GND), J1.57 (GND), J1.71 (GND), J1.73 (GND), R8.2, TP23.1, U6.2 (GND), U7.2 (GND)
ICM_INT1: TP10.1
M2_UART_RX: J1.22 (GPIO_6), U7.3 (I/O2)
M2_UART_TX: J1.20 (GPIO_5), U7.1 (I/O1)
M2_USB_DM: J1.9 (USB_D-), U6.3 (I/O2)
M2_USB_DP: J1.7 (USB_D+), U6.1 (I/O1)
MISO: TP2.1
MOSI: TP3.1
Mag_INT: TP11.1
NRST: TP20.1
unnamed: D7.2 (A), R6.2
SCLK: TP1.1
SWCLK: TP19.1
SWDIO: TP18.1
TRIG_EXT: D1.1 (K), J1.24 (GPIO_7), R7.1
TRIG_IN: D6.3 (COM), R7.2, R8.1, TP15.1
UART_RX: TP17.1, U7.4 (I/O2)
UART_TX: TP16.1, U7.6 (I/O1)
USB_DM: U6.4 (I/O2)
USB_DP: U6.6 (I/O1)

Notes on the sheet:
3.3 V input from the M.2 host
External trigger input: ESD diode, series resistor, clamps to the rails, pull-down
UART protection (route through U7)
Test pads (these replace headers J1 and J2 from Rev-01)
USB protection (route through U6)
M.2 notes: USB uses the standard Key B pins. UART and TRIG_EXT on GPIO_5, GPIO_6 and GPIO_7 are our own choice, to be agreed with Psionic. CONFIG pins are left open until the host's card-detect needs are known.
