KendaroDuong/imu-final-board/(commit log)

2026-11-06 Create Rev-02 final board project
    Add the KiCad project for the M.2 2260 Key B final board. Sensor sheets
    come from Rev-01; the MCU and power/M.2 sheets are new. The PCB holds only
    the board outline so far. Also add the hardware design draft.
    [Accel_Gyro.kicad_sch, Final_Board.kicad_pcb, Final_Board.kicad_sch, MCU.kicad_sch, Mag_Baro.kicad_sch, Power_M2_IO.kicad_sch]
2026-11-10 minor schematic
    [Final_Board.kicad_sch]
